bobh/WirelessAdapter/WirelessAdapter git/Hardware/Wireless Adapter BOM.xlsx

Wireless Adapter BOM
Ref Des | Quantity | Part Number | Description | Vendor
DIY Plastic Project Housing | 1 | 1063302 | 75 x 54 x 27mm | Banggood.com
Modified Plastic Housing | 1 |  | Plastic housing modified with cutout for X1
Circuit Board | 1 | https://oshpark.com/shared_projects/yvBsta7q | Note | OshPark.com
Metal Screws | 2 | 490258 | Flat Phillips Metal #4 x 3/8 | Hilman -- Lowes
U1 | 1 | ESP32-DevKitC from espressif or pinout equivalent | https://esp-idf.readthedocs.io/en/latest/get-started/get-started-devkitc.html | Banggood.com
CN2 | 1 | CP-002A-ND | Pwr Jack 5 mm | Digi-Key
IC1 | 1 | 945-1395-5-ND | DC DC Converter 5V 5W | Digi-Key
C1 | 1 | P19551CT-ND | Cap 10uF 100V | Digi-Key
L1 | 1 | 495-5571-1-ND | Ind 5.6 uH 700ma | Digi-Key
D1 | 1 | 1N5232BFSCT-ND | Diode zener 5.6V 500 mw | Digi-Key
IC3 | 1 | 296-4655-5-ND | 74AHCT125 14 pin dip | Digi-Key
IC Socket | 1 | 571-1-2199298-3 | 14 pin dip | Mouser
R2 | 1 | 691104 | 10K .25W 5% | Jameco
C2 | 1 | 594-K103K10X7RF5UHS | Cap 0.01 uF 50 V | Mouser
C3 | 1 | 478-1841-ND | Cap Tant 10 uF 25V | Digi-Key
Test Points | 1 | 952-2281-ND 10 pos cut to 5 | 2mm centers | Digi-Key
Test Points | 1 | 952-2281-ND 10 pos cut to 4 | 2mm centers | Digi-Key
X1 | 1 | A31444-ND | Jack 8P8C RJ-45 | Digi-Key
U1 Module Socket | 2 | S7018-ND | CONN HEADER FEMALE 20POS .1" TIN | Digi-Key
IC1 Module Socket | 1 | 952-2281-ND 10 pos cut to 3 | 2mm centers | Digi-Key
Config Header | 1 | 952-2281-ND 10 pos cut to 3 | 2mm centers | Digi-Key
Config Jumper | 1 | A26853-ND | Shunt LP w Handle 2 pos sn | Digi-Key
Optional | 1 | LM340T-5.0/NOPB | Optional in place of IC1 | Digi-Key
Optional | 1 | HS115-ND | Heat Sink TO-220 2.5W | Digi-Key
Optional |  |  | Heat Sink compound
