bobh/WirelessAdapter/WirelessAdapter git/Hardware/WirelessAdapterSchematic.pdf

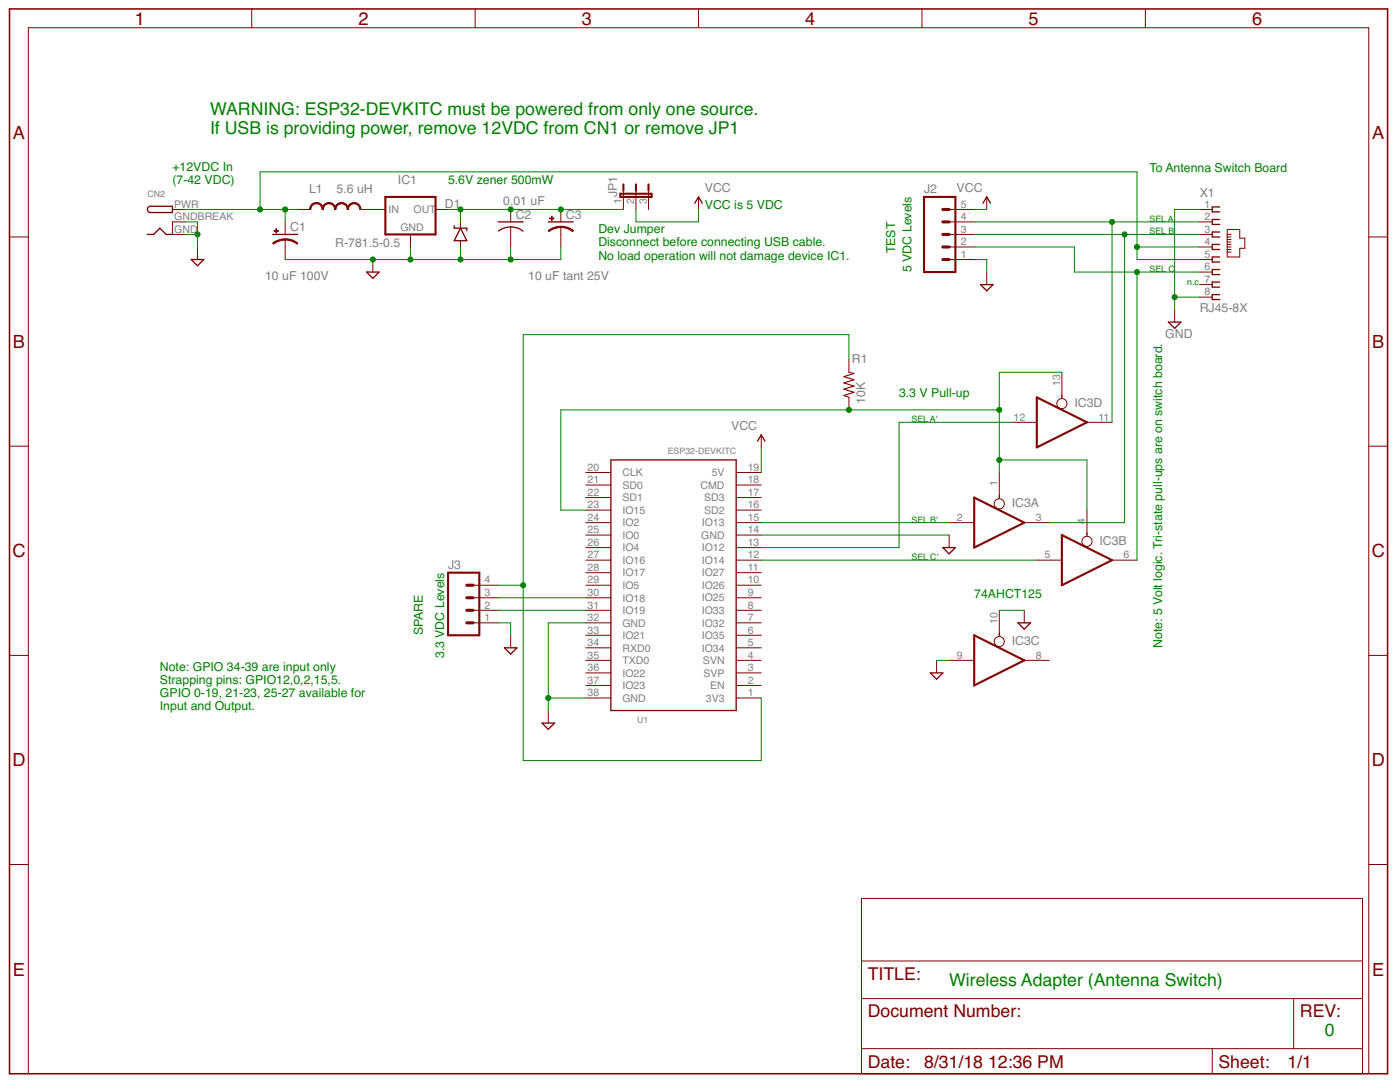
[picture p1: page 1]

WARNING: ESP32-DEVKITC must be powered from only one source.
If USB is providing power, remove 12VDC from CN1 or remove JP1

To Antenna Switch Board TEST

Dev Jumper Disconnect before connecting USB cable. No load operation will not damage device IC1.

Note: 5 Volt logic. Tri-state pull-ups are on switch board.

13 GND

Note: GPIO 34-39 are input only
Strapping pins: GPIO12,0,2,15,5. GPIO 0-19, 21-23, 25-27 available for

Wireless Adapter (Antenna Switch)

Document Number: | REV: 0

Date: 8/31/18 12:36 PM | Sheet: 1/1
