bobh/WirelessAdapter/WirelessAdapter git/Code/WirelessAdapterSW/RemoteControl/unencrypted/AntennaSwitchControlSlave/GlobalDefinitions.h

#ifndef GlobalDefinitions_H_
#define GlobalDefinitions_H_

#include <Arduino.h>

#define HIGH 1
#define LOW 0

#define SEL_A 12
#define SEL_B 13
#define SEL_C 14

#define EnableOutput 15


// Global copy of slave
#define NUMSLAVES 20
#define COMMANDLENGTH 100
//esp_now_peer_info_t slaves[NUMSLAVES] = {};
//int SlaveCnt = 0;


#endif /* GlobalDefinitions_H_ */
